bennett-lahn/feathergauge/build_info/Feather v4 Build List.xlsx

USA Feather Logger v4 Parts List
ITEM | NAME | UNIT COST | UNITS | TOTAL ITEM COST | LINK
1 | Adafruit Feather 32u4 Adalogger | $21.95 | 1 | $21.95 | https://www.adafruit.com/product/2795
2 | Adafruit DS3231 Precision RTC - STEMMA QT | $13.95 | 1 | $13.95 | https://www.adafruit.com/product/5188
3 | STEMMA QT / Qwiic JST SH 4-Pin Cable - 50mm Long | $0.95 | 1 | $0.95 | https://www.adafruit.com/product/4399
4 | STEMMA QT / Qwiic JST SH 4-Pin Cable - 200mm Long | $1.25 | 1 | $1.25 | https://www.adafruit.com/product/4401
5 | Lithium Ion Battery Pack 3.7V 4400 mAh | $19.95 | 1 | $19.95 | https://www.adafruit.com/product/354
6 | Micro Lipo-USB Lilon/LiPoly charger v2 | $5.95 | 1 | $5.95 | https://www.adafruit.com/product/1304
7 | CR1220 12mm Diameter Coin Cell Battery | $0.95 | 1 | $0.95 | https://www.adafruit.com/product/380
8 | SD/MicroSD Memory Card 86B SDHC | $9.95 | 1 | $9.95 | https://www.adafruit.com/product/1294
9 | SparkFun Pressure Sensor Breakout - MS5803-14BA | $80.50 | 1 | $80.50 | https://www.sparkfun.com/sparkfun-pressure-sensor-breakout-ms5803-14ba.html
10 | 1.5" PVC Pipe | $2.17 | 0.67 | $1.45 | https://www.lowes.com/pd/Charlotte-Pipe-1-1-2-in-dia-x-5-ft-L-330-PSI-PVC-Pipe/3133039
11 | 1-1/2-in dia PVC Female Adapter Fitting | $2.29 | 1 | $2.29 | https://www.lowes.com/pd/Charlotte-Pipe-1-1-2-in-x-1-1-2-in-dia-PVC-Schedule-40-Female-Adapter-Fitting/3132709
12 | 1-1/2-in PVC DWV Male Plug | $1.69 | 1 | $1.69 | https://www.lowes.com/pd/Charlotte-Pipe-1-1-2-in-x-1-1-2-in-dia-PVC-Schedule-40-Male-Cleanout-Plug-Fitting/3354904
13 | Oatey 1-1/2-in Gripper PVC DWV Test Plug | $5.65 | 1 | $5.65 | https://www.lowes.com/pd/Oatey-Gripper-1-1-2-in-x-1-1-2-in-x-1-1-2-in-x-1-1-2-in-dia-PVC-Schedule-40-Test-Plug-Fitting/3824165
14 | PVC Glue & Primer | $11.68 | 0.01 | $0.12 | https://www.lowes.com/pd/Oatey-Handypack-8-fl-oz-PVC-Cement-and-Primer/4750411
15 | LOCTITE Waterproof Sealant 2.7-fl oz Gel | $6.48 | 0.05 | $0.32 | https://www.lowes.com/pd/Henkel-Waterproof-Sealant-2-7-fl-oz-Gel-Silicone-Multipurpose-Adhesive/5004266381
16 | VELCRO Brand 0.875-in Sticky Back Squares Hook and Loop Fastener (12-Pack) | $0.36 | 1 | $0.36 | https://www.lowes.com/pd/VELCRO-12-Pack-0-875-in-Black-Fastener/3020016
17 | Screws for MCU and RTC M2 x 25 50 pk | $0.19 | 4 | $0.74 | https://www.mcmaster.com/catalog/130/3484/92010A111
18 | Nuts for MCU and RTC M2 100 pk | $0.06 | 4 | $0.25 | https://www.mcmaster.com/catalog/130/3634/91828A111
19 | Internal MCU+Battery Mount Part 1 | $0.00 | 1 | $0.00 | See GitHub Page
20 | Internal MCU+Battery Mount Part 2 | $0.00 | 1 | $0.00 | See GitHub Page
 |  |  |  | $168.27
optional | Desiccant pack | $0.17 | 1 | $0.17 | https://www.amazon.com/dp/B01M7V19JE?ref=fed_asin_title&th=1
