bennett-lahn/feathergauge/build_info/Internal Component Part 1/USA_Wave_Gage_Insert_003v3.stl

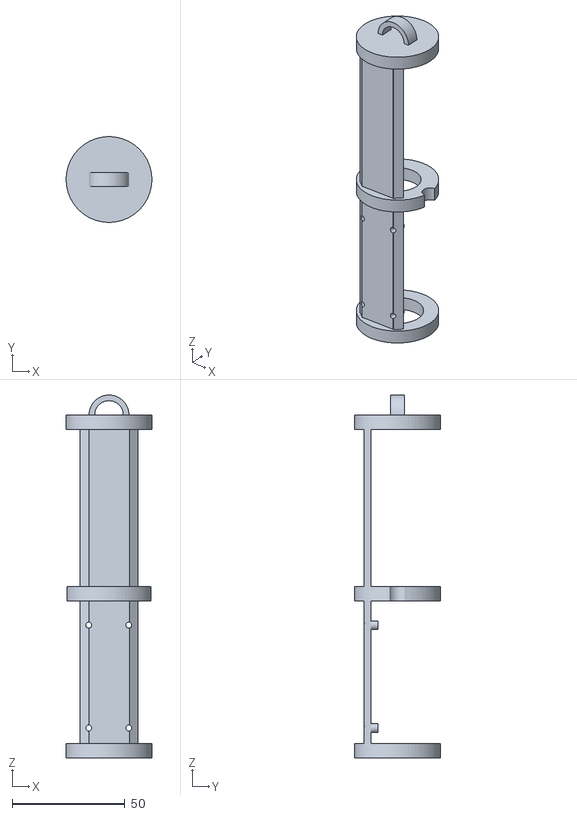
[picture p1: CAD file, 2025-10-20]
build_info/Internal Component Part 1/USA_Wave_Gage_Insert_003v3.stl
38.1 x 38.1 x 161.3
