bennett-lahn/feathergauge/build_info/Internal Component Part 2/rtc_feather_stacker v8.stl

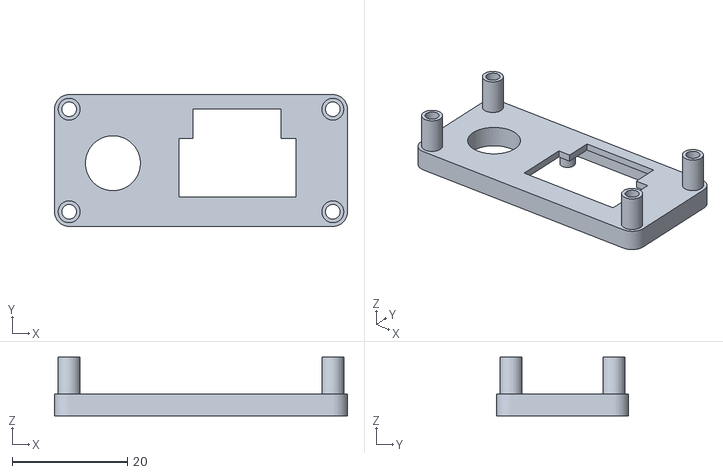
[picture p2: CAD file, 2025-10-20]
build_info/Internal Component Part 2/rtc_feather_stacker v8.stl
50.8 x 22.9 x 10.2
