bennett-lahn/feathergauge/(list of files, cad)

Other CAD files:
build_info/Internal Component Part 1/USA_Wave_Gage_Insert_003v3.f3d
