bennett-lahn/feathergauge/Sketchbooks/Codes_v1/featherDIYv4_rapidstart_continuous_v1/featherDIYv4_rapidstart_continuous_v1.ino

// Must define a malloc failed hook function
// restart peripherals???
// add interrupt detaches

// ===========================
// USER-DEFINED FLAGS: 
// Please set the following three flags according to your sensor type and preferred collection type.
// ===========================

// Set to true for MS5837 (new pressure sensor)
// Set to false for MS5803 (old pressure sensor)
#define USE_NEW_SENSOR false

// Set to false for rapid start
// Set to true for delayed start, using selected start date
#define DELAY_START false

// Set to true for burst sampling
// Set to false for constant sampling
#define BURST_SAMPLING true

// ===========================
// USER INPUTS:
// Please set the below variables to reflect your sampling preferences.
// ===========================
#define SAMPLE_FREQ          1 // Sampling frequency in Hz

// Burst sampling alternates between writing and sleeping according to set periods below
const uint8_t writeSeconds = 1;  // Number of seconds to sample data in burst sampling
const uint8_t sleepSeconds = 120;  // Number of seconds to sleep in burst sampling

// Edit for DELAY start ONLY
#if DELAY_START // Date to start sampling
  const int startYear = 2025; // Year to start sampling
  const int startMonth = 9; // Month to start sampling
  const int startDay = 8; // Day to start sampling
  const int startHour = 11; // Hour to start sampling (24-hr format)
  const int startMinute = 35; // Minute to start sampling
  bool hasStarted = false;
#else // Early dummy date to satisfy later conditional check
  const int startYear = 2000; // DO NOT MODIFY
  const int startMonth = 1;   // DO NOT MODIFY
  const int startDay = 1;     // DO NOT MODIFY
  const int startHour = 12;   // DO NOT MODIFY
  const int startMinute = 0;  // DO NOT MODIFY
#endif

// =========================== USER: DO NOT EDIT BELOW THIS LINE ===========================

// ===========================
// LIBRARIES
// =========================== 

#include <Wire.h> // Arduino library
#include <SPI.h> // Arduino library
#include <SD.h> // Arduino library
#include <EEPROM.h> // Arduino library (?)

#if USE_NEW_SENSOR
  #include "MS5837.h"
#else
  #include "SparkFun_MS5803_I2C.h"
#endif

// A note on using the SparkFun library:
// A very minor change to the SparkFun library is needed for this code to work. The sensorWait function in SparkFun_MS5803_I2C.h must be declared as virtual.
// This change is used to override sensorWait for better power management.

#include "RTClib.h"
#include "TimerOne.h"
#include "LowPower.h"

// Create custom MS5803 class to override sensorWait function for better power management
class CustomMS5803 : public MS5803 {
  public:
    void sensorWait(uint8_t time) {
      // sensorWait in SparkFun library is 1-10ms; the minimum sleep time is 16ms; TWI activity from MS5803 should wake the MCU early
      // Turn off everything except timer 0 (used for millis), timer 1 (used for sampling), and TWI (used to communicate with pressure sensor)
      LowPower.idle(SLEEP_15MS, ADC_OFF, TIMER4_OFF, TIMER3_OFF, TIMER1_ON, TIMER0_ON, SPI_OFF, USART1_OFF, TWI_ON, USB_OFF);
    }
};

// ===========================
// MAGIC NUMBER DEFINITIONS
// ===========================
// Pin definitions
#define LED_PIN 13
#define RTC_INTERRUPT_PIN 1
#define SD_CARD_SELECT_PIN 4
#define BATTERY_VOLTAGE_PIN A9

// Timing and frequency definitions
#define MICROSECONDS_PER_SECOND 1000000
#define SAMPLE_TIME (1.0f / SAMPLE_FREQ)*MICROSECONDS_PER_SECOND // Convert sampling frequency to microseconds
#define TWI_CLOCK_SPEED 400000
#define SERIAL_BAUD_RATE 57600
#define DELAY_START_CHECK_INTERVAL 500
#define ERROR_BLINK_DELAY 100
#define ERROR_PAUSE_DELAY 200
#define ERROR_BLINK_CYCLE 10

// ADC and voltage definitions
#define MAX_ADC_VALUE 1024
#define REFERENCE_VOLTAGE 3.3
#define BATTERY_VOLTAGE_MULTIPLIER 2

// Buffer and data definitions 32
#define BUFFER_SIZE 36              // The ATMega 32u4 only has 2560 bytes of SRAM...set buffer size accordingly
#define BUFFER_WRITE_COUNT 5       // Number of data points that must be present before write occurs; shooting for 512 bytes per write for most efficiency; one line is 40 bytes
#define FILENAME_LENGTH 13
#define FRESHWATER_DENSITY 997
#define SALTWATER_DENSITY 1025

// Error code definitions
#define ERROR_SD_CARD_FAILED 1
#define ERROR_FILE_OPEN_FAILED 5

#define SERIAL_NUMBER_ADDRESS 0

// ===========================
// MACRO SUBSTITUTION
// ===========================
#define cardSelect SD_CARD_SELECT_PIN // Chip select pin for SD card // DO NOT MODIFY

// ===========================
// DATA STRUCTURE FOR CIRCULAR BUFFER
// ===========================
struct DataPoint {
  float pressure;
  float temperature;
  float batteryVoltage;
  uint16_t millisec;
  DateTime now;
  bool valid; // Flag to indicate if this data point is valid
};

// ===========================
// INITIALIZING GLOBAL VARIABLES
// ===========================
#if USE_NEW_SENSOR
  MS5837 newSensor;
#else
  MS5803 oldSensor;
#endif

#if BURST_SAMPLING
  TimeSpan elapsed;
#endif

RTC_DS3231 rtc;
File outputFile; // Used to open, write to, and close files on the SD card

// Circular buffer variables
DataPoint dataBuffer[BUFFER_SIZE];
int bufferHead = 0; // Points to next write position
int bufferTail = 0; // Points to next read position
int bufferCount = 0; // Number of items in buffer
bool bufferOverflow = false; // Flag to indicate buffer overflow

DateTime timeAtBurstSwitch; // Time burst switched between sleep and record
DateTime currentSecond;     // Time of current second
float currentVoltage;       // Voltage of battery, updated every second

// Sampling flag for ISR to main loop communication
volatile bool samplingFlag = false;
volatile bool resetTimerFlag = false;
volatile bool deepSleepFlag = false;
volatile bool burstSleepFlag = false;
volatile bool sleeping = false;

unsigned long millisAtInterrupt = 0; // Number of milliseconds at last 1 Hz interrupt from RTC

// ===========================
// SETUP - SENSOR, TIMESTAMP, SD CARD
// ===========================
void setup() {
  pinMode(LED_PIN, OUTPUT); // Activates the red LED on pin 13
  pinMode(RTC_INTERRUPT_PIN, INPUT_PULLUP);
  Serial.begin(SERIAL_BAUD_RATE);
  while (!Serial); // Wait for serial connection to be established
  Wire.begin();
  Wire.setClock(TWI_CLOCK_SPEED);
  
  if (!rtc.begin()) {
    Serial.println(F("RTC Failed to initialize"));
    error(2);
    return;
  }

  // DS3231 SQW pin requires an external pull-up resistor. The internal pull-up resistors included in the 32u4 are too weak 
  // for square wave output but work for interrupts.
  rtc.disable32K();
  rtc.clearAlarm(1);
  rtc.clearAlarm(2);
  rtc.writeSqwPinMode(DS3231_OFF);

  if (rtc.lostPower()) {
        // This will adjust to the date and time at compilation; recompile everytime MCU is flashed for accuracy
        // If the DS3231 has had continous MCU/battery power since last program flash, the time will not be changed
        rtc.adjust(DateTime(F(__DATE__), F(__TIME__)));
        DateTime setTime = rtc.now();
        Serial.print(F("RTC time set to: "));
        Serial.print(setTime.year());
        Serial.print('/');
        Serial.print(setTime.month());
        Serial.print('/');
        Serial.print(setTime.day());
        Serial.print(' ');
        Serial.print(setTime.hour());
        Serial.print(':');
        Serial.print(setTime.minute());
        Serial.print(':');
        Serial.println(setTime.second());
  }

  currentSecond = rtc.now();
  currentVoltage = getBatteryVoltage();
  
  #if USE_NEW_SENSOR
    if (!newSensor.init()) {
      Serial.println("New pressure sensor failed to initialize");
      error(3);
      return;
    }
    newSensor.setModel(MS5837::MS5837_02BA);
    newSensor.setFluidDensity(FRESHWATER_DENSITY);
  #else
    oldSensor.reset();
    oldSensor.begin();
  #endif

    Serial.print(F("Initializing SD card..."));
  
  if (!SD.begin(cardSelect)) { 
    Serial.println(F("Card Failed or Not Present"));
    error(ERROR_SD_CARD_FAILED);
    return;
  }
  
  for (int i = 0; i < BUFFER_SIZE; i++) {
    dataBuffer[i].valid = false;
  }

  Serial.println(F("Card Initialized."));
  char fileName[FILENAME_LENGTH];
  makeFileName(fileName);
  
  SdFile::dateTimeCallback(setTimeStamp); // Timestamps the .csv file (inserts as metadata)
  outputFile = SD.open(fileName, FILE_WRITE); // Opens .csv file

  if (outputFile) {
    Serial.println(F("File opened"));
    char serialNumber[16];
    EEPROM.get(SERIAL_NUMBER_ADDRESS, serialNumber);
    outputFile.print(F("W.G. Num: "));
    outputFile.print(serialNumber);
    outputFile.print(',');
    outputFile.print(F("Timestamp,Pressure [mbar],Temp [deg C],Battery [VDC]"));
    outputFile.println();
    outputFile.flush();
  } else {
    Serial.println(F("error opening datalog-case1"));
    error(ERROR_FILE_OPEN_FAILED);
  }

  #if DELAY_START
    enterDelayDeepSleep();      
  #else
    DateTime now = rtc.now();
    rtc.disableAlarm(2);
    // Set alarm to go off 1 second from now, DS3231_A1_PerSecond triggers alarm when seconds match
    rtc.clearAlarm(1);
    rtc.setAlarm1(rtc.now() + TimeSpan(1), DS3231_A1_PerSecond); 
    Timer1.initialize(SAMPLE_TIME);
    Timer1.attachInterrupt(triggerSampling); // Every time Timer1 finishes counting down, calls triggerSampling
    attachInterrupt(digitalPinToInterrupt(RTC_INTERRUPT_PIN), resetTimerInterrupt, FALLING);
    millisAtInterrupt = millis();
    // Serial.println(F("READY!"));
    #if BURST_SAMPLING
      timeAtBurstSwitch = rtc.now();
      Serial.print(F("[BURST] Start write window at "));
      Serial.print(timeAtBurstSwitch.hour()); Serial.print(':');
      Serial.print(timeAtBurstSwitch.minute()); Serial.print(':');
      Serial.println(timeAtBurstSwitch.second());
      Serial.print(F("[BURST] writeSeconds=")); Serial.print(writeSeconds);
      Serial.print(F(", sleepSeconds=")); Serial.println(sleepSeconds);
    #endif
  #endif
}

// ===========================
// DATA COLLECTION LOOP
// ===========================
void loop() {
    if (deepSleepFlag) {
      deepSleepLog();
    }

    #if BURST_SAMPLING
      // If true, write time ended; write to SD card and sleep
      if (burstSleepFlag) {
        timeAtBurstSwitch = rtc.now();
        resetTimer();
        attachInterrupt(digitalPinToInterrupt(RTC_INTERRUPT_PIN), resetTimerInterrupt, FALLING);
        Serial.print(F("[BURST] Wake -> start write window at "));
        Serial.print(timeAtBurstSwitch.hour()); Serial.print(':');
        Serial.print(timeAtBurstSwitch.minute()); Serial.print(':');
        Serial.println(timeAtBurstSwitch.second());
        burstSleepFlag = false;
      } else if (elapsed.totalseconds() > writeSeconds || bufferCount != 0) {
        DataPoint data;
        while (readFromBuffer(&data)) {
          writeToOutputFile(data.now, data.millisec, data.pressure, data.temperature, data.batteryVoltage);
        }
        outputFile.flush();
        DateTime endTime = rtc.now();
        Serial.print(F("[BURST] End write window at "));
        Serial.print(endTime.hour()); Serial.print(':');
        Serial.print(endTime.minute()); Serial.print(':');
        Serial.println(endTime.second());
        Serial.print("Elapsed time: ");
        Serial.println(elapsed.totalseconds());
        enterBurstDeepSleep();
      }
    #endif

    if (bufferOverflow) {
      Serial.println(F("WARNING: Buffer overflow detected!"));
      // TODO: Add some sort of flag to file to indicate that an error occurred
      bufferOverflow = false;
    }

    if (samplingFlag) {
      performSensorReading();
      samplingFlag = false;
    }

    if (resetTimerFlag) {
      // Serial.print("Resetting millis, was: ");
      // Serial.println(millisAtInterrupt);
      resetTimer();
      resetTimerFlag = false;
      // Serial.print("Now: ");
      // Serial.println(millisAtInterrupt);
    }

    if (bufferCount > BUFFER_WRITE_COUNT - 1) {
      DataPoint data;
      int writeCount = 0;
      while (readFromBuffer(&data) && writeCount < BUFFER_WRITE_COUNT) {
        writeToOutputFile(data.now, data.millisec, data.pressure, data.temperature, data.batteryVoltage);
        writeCount++;
        if (samplingFlag) {
          performSensorReading();
          samplingFlag = false;
        }
      }
      Serial.print(F("Starting write at time: "));
      Serial.println(millis());
      outputFile.flush();
      Serial.print(F("Wrote "));
      Serial.print(writeCount);
      Serial.print(F(" data points to SD card at time "));
      Serial.println(millis());
    }
    // Finished writing to SD card, sleep until next sampling time or interrupt from timers/RTC
    setForeverIdleSleep();
}

void triggerSampling() {
    samplingFlag = true;
}

void performSensorReading() {
    DateTime now = currentSecond;
    
    float temp2, pres;
    #if USE_NEW_SENSOR
      newSensor.read();
      temp2 = newSensor.temperature();
      pres = newSensor.pressure();
    #else
      temp2 = oldSensor.getTemperature(CELSIUS, ADC_512);
      pres = oldSensor.getPressure(ADC_4096);
    #endif
    uint16_t millisec = (millis() - millisAtInterrupt) % 1000; // If above 1000, rollover to next second

    addToBuffer(now, millisec, pres, temp2, currentVoltage);
    // Serial.println(F("Sampling complete"));
    // Print the recorded data to Serial
    // Serial.print(F("Recorded: "));
    // Serial.print(now.year());
    // Serial.print('/');
    // Serial.print(now.month());
    // Serial.print('/');
    // Serial.print(now.day());
    // Serial.print(' ');
    // Serial.print(now.hour());
    // Serial.print(':');
    // Serial.print(now.minute());
    // Serial.print(':');
    // Serial.print(now.second());
    // Serial.print(':');
    // Serial.print(millisec);
    // Serial.print(", ");
    // Serial.print(pres);
    // Serial.print(", ");
    // Serial.print(temp2);
    // Serial.print(", ");
    // Serial.println(actualBatteryVoltage);
}

// ===========================
// RESET TIMER INTERRUPT
// ===========================
// Sets flag to reset the timer interrupt every second according to RTC to prevent timer desyncing from the RTC
void resetTimerInterrupt() {
  resetTimerFlag = true;
}

void resetTimer() {
  millisAtInterrupt = millis();
  currentSecond = rtc.now();
  #if BURST_SAMPLING
    elapsed = currentSecond - timeAtBurstSwitch;
  #endif
  // currentVoltage = getBatteryVoltage();
  rtc.clearAlarm(1);
  rtc.setAlarm1(currentSecond + TimeSpan(1), DS3231_A1_PerSecond);
}

float getBatteryVoltage() {
  int sensorValue = analogRead(BATTERY_VOLTAGE_PIN);
  float batteryVoltage = (sensorValue * REFERENCE_VOLTAGE) / MAX_ADC_VALUE; // Adafruit docs says this should also multiply by 2?
  float actualBatteryVoltage = batteryVoltage * BATTERY_VOLTAGE_MULTIPLIER; // Adjust multiplier based on your divider
  return actualBatteryVoltage;
}

void makeFileName(char* fileName) {
  // Format: MM-DD-00.csv (e.g., 04-23-01.csv)
  DateTime now = rtc.now();
  
  // Build filename: MM-DD-
  fileName[0] = '0' + (now.month() / 10);
  fileName[1] = '0' + (now.month() % 10);
  fileName[2] = '-';
  fileName[3] = '0' + (now.day() / 10);
  fileName[4] = '0' + (now.day() % 10);
  fileName[5] = '-';
  fileName[6] = '0';
  fileName[7] = '0';
  fileName[8] = '.';
  fileName[9] = 'c';
  fileName[10] = 's';
  fileName[11] = 'v';
  fileName[12] = '\0';
  // Find the next available file index for this day
  for (uint8_t fileIndex = 1; fileIndex < 100; fileIndex++) {
    if (!SD.exists(fileName)) {
      break;
    }
    fileName[6] = '0' + (fileIndex / 10);
    fileName[7] = '0' + (fileIndex % 10);
  }
  
  Serial.print(F("File name: "));
  Serial.println(fileName);
}

// ===========================
// SETTING FILE DATE AND TIME
// ===========================
// Sets file creation/modification date and time for the SD card using the RTC
void setTimeStamp(uint16_t* date, uint16_t* time) {
  DateTime now = rtc.now();
  *date = FAT_DATE(now.year(), now.month(), now.day());
  *time = FAT_TIME(now.hour(), now.minute(), now.second());
}

// ===========================
// ERRORS/TROUBLESHOOTING
// ===========================
// Triggers the LED on pin 13 to blink a certain number of times during unrecoverable errors
void error (uint8_t errno) {
  while (1) {
    uint8_t blinkCount; // Counts error blinks
    for (blinkCount = 0; blinkCount < errno; blinkCount++) {
      digitalWrite(LED_PIN, HIGH);
      delay(ERROR_BLINK_DELAY);
      digitalWrite(LED_PIN, LOW);
      delay(ERROR_BLINK_DELAY);
    }
    for (blinkCount = errno; blinkCount < ERROR_BLINK_CYCLE; blinkCount++) {
      delay(ERROR_PAUSE_DELAY);
    }
  }
}

// ===========================
// CIRCULAR BUFFER FUNCTIONS
// ===========================
// Add data point to circular buffer (called from interrupt)
void addToBuffer(DateTime now, int millisec, float pressure, float temperature, float batteryVoltage) {
  if (bufferCount >= BUFFER_SIZE) {
    bufferOverflow = true;
    bufferTail = (bufferTail + 1) % BUFFER_SIZE;
  } else {
    bufferCount++;
  }
  
  dataBuffer[bufferHead].now = now;
  dataBuffer[bufferHead].millisec = millisec;
  dataBuffer[bufferHead].pressure = pressure;
  dataBuffer[bufferHead].temperature = temperature;
  dataBuffer[bufferHead].batteryVoltage = batteryVoltage;
  dataBuffer[bufferHead].valid = true;
  
  bufferHead = (bufferHead + 1) % BUFFER_SIZE;
}

// Read data point from circular buffer (called from main loop)
bool readFromBuffer(DataPoint* data) {
  if (bufferCount == 0) {
    return false; // Buffer is empty
  }
  
  // Copy data from buffer
  data->now = DateTime(dataBuffer[bufferTail].now.unixtime());
  data->millisec = dataBuffer[bufferTail].millisec;
  data->pressure = dataBuffer[bufferTail].pressure;
  data->temperature = dataBuffer[bufferTail].temperature;
  data->batteryVoltage = dataBuffer[bufferTail].batteryVoltage;
  data->valid = dataBuffer[bufferTail].valid;
  
  // Mark as invalid and move tail
  dataBuffer[bufferTail].valid = false;
  bufferTail = (bufferTail + 1) % BUFFER_SIZE;
  bufferCount--;
  
  return data->valid;
}

void writeToOutputFile(DateTime now, int millisec,float pressure, float temperature, float batteryVoltage) {
  // Write data to SD card
  outputFile.print(now.year());
  outputFile.print('/');
  outputFile.print(now.month());
  outputFile.print('/');
  outputFile.print(now.day());
  outputFile.print(",");
  outputFile.print(now.hour());
  outputFile.print(':');
  if (now.minute() < 10) {
    outputFile.print("0");
  }
  outputFile.print(now.minute());
  outputFile.print(':');
  if (now.second() < 10) {
    outputFile.print("0");
  }
  outputFile.print(now.second());
  outputFile.print(':');
  if (millisec < 10) {
    outputFile.print("00");
  } else if (millisec < 100) {
    outputFile.print("0");
  }
  outputFile.print(millisec);
  outputFile.print(",");
  outputFile.print(pressure);
  outputFile.print(",");
  outputFile.print(temperature);
  outputFile.print(",");
  outputFile.print(batteryVoltage);
  outputFile.println();
}

void deepSleepInterrupt() {
  deepSleepFlag = true;
}

void deepSleepLog() {
  deepSleepFlag = false;
  DateTime now = rtc.now();
  DateTime startDateTime(startYear, startMonth, startDay, startHour, startMinute, 0);
  if (now.unixtime() > startDateTime.unixtime()) {
    rtc.clearAlarm(1);
    rtc.clearAlarm(2);
    rtc.disableAlarm(2);
    // Set alarm to go off 1 second from now, DS3231_A1_PerSecond triggers alarm when seconds match
    rtc.setAlarm1(now + TimeSpan(1), DS3231_A1_PerSecond);
    #if BURST_SAMPLING
      timeAtBurstSwitch = rtc.now();
    #endif
    Timer1.initialize(SAMPLE_TIME);
    Timer1.attachInterrupt(triggerSampling); // Every time Timer1 finishes counting down, calls triggerSampling
    attachInterrupt(digitalPinToInterrupt(RTC_INTERRUPT_PIN), resetTimerInterrupt, FALLING);
    millisAtInterrupt = millis();
    // Now continue with regular program execution
  } else {
    performSensorReading();
    DataPoint data;
    writeToOutputFile(data.now, data.millisec, data.pressure, data.temperature, data.batteryVoltage);
    outputFile.flush();
    rtc.clearAlarm(1);
    rtc.clearAlarm(2);
    enterDelayDeepSleep();
  }
}

void enterDelayDeepSleep() {
  // Set RTC alarm to correct date
  // Serial.println(F("Entering RTC deep sleep"));
  DateTime startDateTime(startYear, startMonth, startDay, startHour, startMinute, 0);
  rtc.clearAlarm(1);
  rtc.clearAlarm(2);
  attachInterrupt(digitalPinToInterrupt(RTC_INTERRUPT_PIN), deepSleepInterrupt, FALLING);
  rtc.setAlarm1(startDateTime, DS3231_A1_Date); // Alarm 1 triggers at the start time
  rtc.setAlarm2(startDateTime, DS3231_A2_PerMinute); // Alarm 2 triggers every hour, taking a sample to track when/if battery dies
  LowPower.powerDown(SLEEP_FOREVER, ADC_OFF, BOD_OFF);
}

void enterBurstDeepSleep() {
  rtc.clearAlarm(1);
  DateTime nextWake(rtc.now() + TimeSpan(0, 0, 0, sleepSeconds));
  Serial.print(F("[BURST] Next wake scheduled at "));
  Serial.print(nextWake.hour()); Serial.print(':');
  Serial.print(nextWake.minute()); Serial.print(':');
  Serial.println(nextWake.second());
  rtc.clearAlarm(1);
  attachInterrupt(digitalPinToInterrupt(RTC_INTERRUPT_PIN), burstSleepInterrupt, FALLING);
  rtc.setAlarm1(nextWake, DS3231_A1_Minute);
  // LowPower.idle(SLEEP_FOREVER, ADC_OFF, TIMER4_OFF, TIMER3_OFF, TIMER1_OFF, TIMER0_OFF, SPI_OFF, USART1_OFF, TWI_OFF, USB_OFF);  
  LowPower.powerDown(SLEEP_FOREVER, ADC_OFF, BOD_OFF);
}

void burstSleepInterrupt() {
  burstSleepFlag = true;
}

// Idle sleep should be used whenever millisecond tracking (timer 0) is needed or timer 1 is used for sampling
// With timer 0 enabled, the MCU will wake up every ms, this is a necessary evil for millisecond tracking
void setForeverIdleSleep() {
  // TODO: See if turning on SPI/TWI improves data loss
  LowPower.idle(SLEEP_FOREVER, ADC_OFF, TIMER4_OFF, TIMER3_OFF, TIMER1_ON, TIMER0_ON, SPI_ON, USART1_OFF, TWI_ON, USB_OFF);
}
