bennett-lahn/feathergauge/(commit log)

2025-05-12 Create jorch_featherDIY_customizable
    First, I modified the original four files:
    - Improved code readability and organization
    - Clearer commenting
    - Headings for each section
    - All variable names are more intuitive
    - Added sensor selection flag
    - Set USE_NEW_SENSOR to true for MS5837, false for MS5803
    - Used conditionals to
    - Include the appropriate sensor library
    - Declare and initialize the correct sensor type
    - Call the correct methods for reading temperature and pressure
    Then, I combined them into a single file:
    - Merged all files into a streamlined script
    - Added user-defined flags at the top for easy configuration
    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
2025-08-06 Refactor jorch_featherDIY_customizable.ino: - Added circular buffer to store data samples before writing to SD card - Moved sensor sampling to an interrupt, so SD card writes never block sensor reads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
2025-09-02 Added FreeRTOS
    - Created FreeRTOSConfig.h with application-specific definitions for FreeRTOS.
    - Developed jorch_featherDIY_freertos.ino to implement FreeRTOS tasks for sensor data handling and SD card writing.
    - Integrated sensor selection and improved power management features.
    - Established a queue for data points and implemented FreeRTOS task scheduling for efficient data processing.
    Program size is currently too large for 32u4 memory.
    [jorch_featherDIY_freertos.ino, serial_number_generator.ino]
2025-09-03 Update jorch_featherDIY_customizable.ino to enhance sampling and buffer management:
    - Simplify/shorten interrupts to improve performance
    - Update RTC alarm to properly fire every second.
    - Reimplemented low power mode for MS5803 sensorWait() and within Arduino loop() function.
2025-09-08 Added support for burst sampling and finished delayed start, created python script to analyze wave gauge output
    - Reimplemented burst sampling using MCU sleep modes with RTC as a source for wake interrupts (currently untested)
    - Moved deep sleep interrupt body into loop() function, triggered by interrupt flag (currently untested)
    - Implemented csv_data_analyzer.py to analyze number of missing points in wave gauge output .csv file
    [jorch_featherDIY_freertos.ino]
2025-09-10 Implement data gap analysis in csv_data_analyzer.py and enhance jorch_featherDIY_customizable.ino:
    - Added analyze_data_gaps function to analyze data gaps and count points between them in csv_data_analyzer.py.
    - Modified jorch_featherDIY_customizable.ino by reducing calls to RTC and battery ADC, which now happen at 1 HZ instead of sampleFreq.
    - Increased TWI clock speed to fast (400,000 kHz) from standard.
    - Removed Timer1 reset every second. Intent is to trade marginal drift from never syncing Timer1 to RTC with overhead from restarting timer.
    - Removed unused FreeRTOSConfig.h files from various directories to clean up the codebase.
    [featherDIYv4_rapidstart_continuous_v1.ino]
2025-09-16 Refactor jorch_featherDIY_customizable.ino to enhance burst sampling functionality and improve code clarity:
    - Updated burst sampling logic to use seconds instead of minutes for write and sleep durations.
    - Added logging for burst sampling events, including start and end times.
    - Re-enabled the sensorWait sleep macro.
    - Adjusted buffer handling and removed unused battery voltage assignments.
    - Improved formatting for time output in the writeToOutputFile function.
2025-09-16 Finished single datapoint burst sampling
    - Introduced BURST_SAMPLING_ONE_SAMPLE flag to allow single sample burst mode.
    - Adjusted write and sleep durations for burst sampling to optimize performance.
    - Added power management macros for Timer 4 and ADC to improve low power operation.
    - Updated sensor reading and buffer handling logic to accommodate new burst sampling mode.
    - Improved clarity and organization of the setup and loop functions.
2025-09-30 Remove unneeded .csv files
    [data.CSV, gaps.CSV]
2025-09-30 Add custom MS5803 I2C library for pressure sensor
    - Introduced SparkFun_MS5803_I2C.h and SparkFun_MS5803_I2C.cpp files. These files should be used instead of downloading the SparkFun library directly.
    - Added getSensorReadings() function, which optimizes pressure sensor requests when both temperature and pressure are desired. This should be used instead of included getTemperature() and getPressure() when both measurements are desired.
    - Outlined sensorWait() function that uses LowPower library to sleep during sensor conversion, commented out until wave gauge behavior is more stable.
2025-10-06 Add battery voltage analysis script
    - Introduced analyze_battery_voltage.py for analyzing and comparing battery voltage in FeatherGauge datasets.
    - The script loads CSV files, aligns timestamps, fits sigmoidal discharge curves, and overlays measured voltage with fitted curves.
    - Added functionality for handling different dataset types and improved data parsing and cleaning processes.
2025-10-06 Enhance battery voltage analysis script
    - Added functionality to handle backward time jumps in timestamp data, ensuring accurate elapsed time calculations.
    - Introduced a new method to compute rolling average sampling rates (Hz) for better data analysis.
    - Preserved sampling factor metadata during data processing to maintain consistency in computations.
    - Updated plotting functions to include average Hz on a secondary y-axis, improving visualization of data trends.
2025-10-13 Add EEPROM test sketch for serial output
    - Introduced eeprom_test.ino to read and print EEPROM values over serial for automated testing.
2025-10-20 Add PowerShell wrapper for Feather 32u4 programming
    - Introduced a new PowerShell script to facilitate the programming of Feather 32u4 devices via WSL.
    - The script checks prerequisites, installs necessary tools, detects connected Adafruit devices, binds them to WSL, and runs a specified Linux programming script.
    - Fixed merge conflicts
    [serial_number_generator.ino]
2025-10-20 Reoragnize files and documentation
    - Deleted the Library Setup Guide and several outdated sensor diagrams to streamline the repository.
    - Moved obsolete Arduino sketches related to previous versions of the Feather 32u4 projects.
    - Cleaned up files, file names to improve project organization and maintainability.
    [Feather v4 Build List.xlsx, USA_Wave_Gage_Insert_003v3.f3d, USA_Wave_Gage_Insert_003v3.stl, rtc_feather_stacker v8.stl]
2025-11-18 Added LED warm-up indicator to improve setup reliability in the field
    - Introduced LED warmup indicator functions to enhance startup diagnostics.
    - The intent of this LED flashing is to make it possible to verify that the sensor is recording data when deployed in the field without access to serial monitor
    - By default, the LED will flash for the first 5 samples taken. If using burst sampling, this amount may be lower if the number of samples taken per burst is < 5. In single sample burst mode, the LED flashes once for 100ms.
    - Also added custom versions of SparkFun MS5803 library that was previously untracked by Git.
    - Slightly reduced sensorWait times to better reflect the actual processing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
2025-11-19 Finished testing LED initialization diagnostic and fixed Serial bug. - Serial port was opening when it shouldn't, blocking proper millisecond counting and burst sampling.
2025-11-24 Reimplemented MCU sleep during sensor polling and switched from define statements to constexpr, other style improvements
    - Added sleep during sensor polling using CustomMS5803. Change saw no impact to sensor poll drop rates.
    - Tweaked sleep settings for SPI and TWI, slightly improving sensor poll drop rates while reducing the number of components powered during sleep.
    - Updated variable definitions to use `constexpr` for better type safety and optimization.
    - Cleaned up commented-out code and unnecessary comments for clarity.
    - Added function declarations for better organization and readability.
2025-11-26 Refactor battery voltage pin definition to use constexpr for improved type safety
    - Changed the definition of BATTERY_VOLTAGE_PIN from a #define to a constexpr for better optimization.
    - Added comments to clarify the purpose of LED warmup constants, enhancing code readability.
2025-11-26 Fix syntax error in BATTERY_VOLTAGE_PIN definition by adding missing semicolon
2026-02-17 Implement device monitoring and reattachment in Windows PowerShell script
    - Added a new function to monitor and reattach devices that become detached during the programming process.
    - Updated the Linux script invocation to include device monitoring, ensuring devices are automatically reattached if they disconnect.
    - Refactored existing functions for better clarity and added error handling for device state checks.
    - Adjusted paths in the shell script to reflect new project structure and improved logging for better debugging.
2026-02-24 Refactor sensor sleep management and update library usage notes
    - Simplified user-defined flags comment for clarity.
    - Removed custom MS5803 class and related comments to streamline the code.
    - Enhanced documentation regarding the SparkFun library and its requirements for proper functionality.
    - Updated sensorWait function to clarify timing dependencies and power management.
    - Added important notes on library usage and processor state assumptions for better guidance.
2026-02-24 Refactor delayStartDeepSleepLoop for clarity and functionality
    - Updated setup() loop so that the rest of setup completes after deep sleep finishes
    - Updated the delayStartDeepSleepLoop function to ensure the system state remains unchanged after execution.
    - Changed the loop structure to a while(true) for better readability.
    - Added detachInterrupt and alarm clearing to prevent unintended interrupts.
    - Improved comments for better understanding of the deep sleep process.
2026-02-24 Add header and user configuration files for Feather Gauge
    - Introduced `feathergauge_code.h` to centralize constant definitions, data structures, and function declarations for improved organization and readability.
    - Created `user_config.h` for user-defined flags and sampling preferences, allowing easier customization of sensor settings and operational parameters while seperating user edits from critical code.
    - Updated `feathergauge_code.ino` to include the new header files, streamlining the main code file and enhancing maintainability.
2026-03-15 Simplify delay start alarm configuration
    - Refined alarm configuration in delayStartDeepSleepLoop to reduce alarms needed to one.
    - Addressed case where MCU could sleep forever if delay start date passed present time before sleeping.
    - Updated periodic logging in deep sleep to use newly calculated date instead of stale global value.
    - Enhanced comments for clarity regarding RTC alarm settings and deep sleep behavior.
2026-03-18 Fix stale data bug in delay start data
    - Renamed `currentSecond` to `currentDateTime` for clarity in time tracking.
    - Added secondary initialization of currentDateTime and currentVoltage if delay start is used to avoid a stale time being used for the 1st second after delay start concludes.
    - Small comment changes to improve clarity of delay start, RTC behavior.
2026-04-10 Implemented automatic Powershell upload script - Added PowerShell script that automatically flashes eeprom test program, flashes and configures rtc setup, and finally flashes the main program to all 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
    [eeprom_test.ino, rtc_setup.ino]
2026-04-10 Refactor feathergauge_code.ino, .h organization
    - Moved macros for Timer 4 power management into header file
    - Updated the main code to utilize the new CustomMS5803 class, streamlining sensor initialization and readings.
    - Removed legacy code related to the "new" sensor (never used) for clarity and maintainability.
2026-04-13 Enhance PowerShell script for Feather firmware programming
    - Updated usage instructions to include a new -Debug parameter for verbose output.
    - Added a Debug switch to control detailed logging in the script.
    - Introduced Write-Detail function for internal messages that only appear when -Debug is enabled.
    - Created a new batch file (run_programmer.bat) to simplify the execution of the PowerShell script, including error handling and user prompts.
    - Fixed race condition where script when detect "new" enumerated USB device after triggering bootloader before the bootloader could actually launch.
2026-04-20 Fix: Modify resetTimerInterrupt
    - Moved millis update into ISR.
    - Pre-emptively update DateTime object in ISR to prevent milliseconds from pulling ahead of RTC time.
    - Added downcast of sensor readings with millisecond count of 1000 to 999, effectively eliminating this data bug while staying within timer's 2ms precision.
2026-04-27 Refactor MS5803 sensor reading calculations
    - Removed pow() usage in temperature calculations, eliminating source of floating point emulation.
    - Fixed order of operations error that was reducing data precision.
    - Added a TODO comment for handling potential I2C read errors.
    - Removed unnecessary delay in sensorWait method.
2026-04-27 Refactor MS5803 getSensorReadings()
    - Updated getSensorReadings to include a reading_mode parameter, allowing for optional pressure calculation.
    - Modified getMeasurements to utilize the new reading_mode, improving performance by avoiding unnecessary calculations.
    - Improved temperature and pressure calculation precision by correcting order of operations.
    - Optimized temperature and pressure calculation logic by converting division by powers of 2 to bitshifts.
2026-05-04 Refactor: Update feathergauge_code to improve SD card performance and implement ISO 6801 naming. Convert SparkFun MS5803 to fixed point.
    - Replaced SD library with SdFat to support filenames longer than 8.3 format.
    - Modified filename generation to include serial number and updated ISO 6801 format.
    - Removed circular buffer implementation. Program instead writes directly to the SD library's internal 512 byte buffer.
    - Reduced period of file flushes to only once every 10 seconds. This improves SD performance but means the last 10 seconds of data are lost upon power failure.
    - Adjusted sensor reading and battery voltage functions to return fixed-point values.
    - Adjusted writeToOutputFile to us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
2026-05-06 Fix: Correctly display milliseconds over 1000
    - Modified fixed-point arithmetic in appendPadded3() to also support
    4-digit numbers, renamed to appendPadded34()
    - Added code for file rollover handling (currently unused)
    - Minor documentation changes
2026-05-11 Update PowerShell script and batch file for Feather programming
    - Increased timeout duration in Wait-ForPortAtLocation function from 5 to 10 seconds to improve reliability.
    - Added a comment to clarify that the script should wait until the COM port has dropped before proceeding.
    - Renamed batch file title and echo message from "Feather Gauge Firmware Programmer" to "Feather Wave Gauge Programmer".
2026-05-11 Add bootloader triggering logic in PowerShell script
    - Implemented sequential bootloader triggering for discovered devices with a 2-second delay between each.
    - Added a 9-second wait after triggering all bootloaders to allow devices to fully enumerate before proceeding.
2026-05-11 Enhance PowerShell script with isolated Arduino CLI setup
    - Updated the PowerShell script to create an isolated arduino-cli environment within the automatic_programming directory, ensuring that the host computer's global Arduino installation remains untouched.
    - Added logic to handle stale or corrupt winget source catalogs, automatically repairing and retrying installations as needed.
    - Modified library installation commands to utilize a local configuration file, improving clarity and control over library management.
    - Updated the batch file to include a debug flag.
    - Removed the obsolete SD-master.zip file from the libraries directory.
2026-05-11 Fix: Correctly implement DTR serial handling.
    - Fix: Updated serial port configuration to set DTR high when reading EEPROM. This caused some systems to fail to read the EEPROM value returned over serial.
    - Added a check to ensure the script is not run as an Administrator, preventing potential issues with winget symlinks.
    - Removed the obsolete Install-CoreLibraries function to streamline library management.
    - Added arduino-cli.yaml from automatic_programming environment to gitignore
2026-05-11 Refactor: Simplify admin check and enhance winget installation command
    - Updated the admin check logic to fix operator order precedence bug.
    - Modified the winget installation command to include the --exact and --source winget flags to make install more deterministic.
2026-05-27 Update README and scripts for consistent directory naming and remove outdated files
    - Changed directory references in repository and PowerShell script from `Sketchbooks` to `sketchbooks` and `Obsolete` to `obsolete` for consistency.
    - Deleted obsolete `PROGRAMMING_GUIDE.md`, `troubleshoot_feather.sh`, and `WINDOWS_USAGE.md` files to streamline documentation.
2026-05-27 Add .gitattributes file for G-code documentation and update feathergauge part list
    [Feather v4 Build List.xlsx]
2026-06-01 Enhance currentDateTime handling in feathergauge code
    - Updated comments to clarify that currentDateTime must be accessed with interrupts disabled to prevent race conditions.
    - Adjusted the implementation in performSensorReading and resetTimer functions to ensure currentDateTime is updated safely.
    - Added warnings in setup regarding the impact of enabling serial communication on RTC timer interrupts.
2026-06-01 Fix: Update millisAtInterrupt handling and function signatures in feathergauge code to prevent race conditions
    - Disabled interrupts when accessing currentDateTime and millisAtInterrupt to prevent race conditions with resetTimerInterrupt ISR.
    - Changed millisAtInterrupt to be volatile to ensure safe access in interrupt contexts.
    - Updated function signatures to use uint16_t for millisec parameter to prevent sign conversion issues.
2026-06-05 Add file handling and recovery mechanism in feathergauge code
    - Introduced a new global char array `fileName` to store the currently open file name.
    - Added `recoverSdCard` function to handle SD card errors by attempting to reset the state and reopen the current file.
    - Updated file synchronization calls to utilize the new recovery mechanism,.
2026-06-29 Add mock environment, test files for unit and integration testing
    - Added unit and integration tests for all existing code.
    - Refactored `feathergauge_code.h` and `feathergauge_code.ino` to support native testing with mock implementations for Arduino libraries.
    - Added mock files for Arduino environment, EEPROM, SD, RTC, and sensor handling to facilitate unit testing without hardware dependencies.
    - Introduced `platformio.ini` for managing build environments and dependencies.
    - Updated `.gitignore` to exclude PlatformIO files.
    - Enhanced function signatures and added inline documentation for clarity and maintainability.
